elin694/BLDC-Motor-Kraken-x694/breadboard schematics/prototype-bldc-6-step-commutation_normalHighSide.txt

$ 1 0.00009999999999999999 0.6798259793203881 43 9 43 5e-11
w 448 368 448 416 0
w 32 320 32 352 0
w -16 352 -16 432 0
r -16 432 -16 496 0 1000
w 32 384 32 432 0
r 32 432 32 496 0 1000
w 80 416 80 432 0
r 80 432 80 496 0 1000
w -16 496 32 496 0
w 32 496 80 496 0
v -160 352 -16 352 4 5 100 5 0 2.0943951023931953 0.33
v -128 384 32 384 4 5 100 5 0 4.1887902047863905 0.33
v -160 416 -32 416 4 5 100 5 0 0 0.33
w -32 416 80 416 0
w -160 352 -160 384 0
w -160 384 -160 416 0
w -160 384 -128 384 0
w 448 448 464 448 0
d 464 448 464 416 2 default
w -160 416 -160 496 0
w -160 496 -16 496 0
s 112 192 112 128 0 0 false
s 32 144 32 64 0 0 false
s 192 320 192 288 0 0 false
s 112 320 112 288 0 0 false
s 32 320 32 288 0 0 false
v 1072 0 944 0 0 0 40 5 0 0 0.5
w 880 272 944 272 0
w 880 304 944 304 0
w 944 240 880 240 0
207 880 496 912 496 5 Power\sCap3
207 704 496 736 496 5 Power\sCap2
207 640 128 688 96 5 Power\sCap2
207 816 128 864 96 5 Power\sCap3
207 528 496 560 496 5 Power\sCap1
207 800 -32 720 0 5 Power_Gnd
207 -160 496 -96 464 5 Power_Gnd
w 448 368 464 368 0
w 464 416 496 416 0
207 624 480 624 544 5 Power_Gnd
w 112 320 112 384 0
w 464 448 496 448 0
w 192 320 192 416 0
w 640 448 672 448 0
w 640 416 672 416 0
w 624 368 640 368 0
d 640 448 640 416 2 default
w 624 448 640 448 0
w 624 368 624 416 0
w 800 368 800 416 0
w 800 448 816 448 0
d 816 448 816 416 2 default
w 800 368 816 368 0
w 816 448 864 448 0
w 448 448 448 480 0
w 624 448 624 480 0
w 800 480 800 448 0
w 464 128 496 128 0
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
o 70 1 0 x283016 5 0.1 4 2 1 10 0 70 3 0.2 0
o 217 1 0 x283016 5 0.1 5 2 1 10 0 217 3 0.2 0
38 12 F1 3 9 100 -1 F_CLow
38 11 F1 3 9 100 -1 f_BLow
38 10 F1 3 9 100 -1 F_ALow
38 206 F1 3 9 100 -1 f_Chigh
38 207 F1 3 9 100 -1 f_Bhigh
38 208 F1 3 9 100 -1 f_AHigh
