elin694/BLDC-Motor-Kraken-x694/code/x694_BlockComm/x694_blockComm_SinglePhaseTest/src/globals.h

#pragma once

// #define led_14 GPIO_NUM_14
#define GLOBALS_H
#define phaseAHighPort 33
#define phaseALowPort 14
#define phaseBHighPort 17
#define phaseBLowPort 16
#define phaseCHighPort 26
#define phaseCLowPort 32
#define pot 35 // or 35
// #define adcChannel 34
#define adcChannel ADC_CHANNEL_7 // diagonal pairing with physical placement

#define inlineShuntC 36 //Vp 
#define inlineShuntA 39 //Vn
