elin694/BLDC-Motor-Kraken-x694/code/x694_foc_arduinoFramework/src/parkClarkTestCases.h

#define CP_TEST_CASES
 float phaseA_test = 2; //phase A current
 float phaseB_test = 2; //Phase C Current
 float phaseC_test = -phaseA_test-phaseB_test; //Phase C Current
 float as5600input_test = 0; // 

 //input calcualted google sheets angle here
