elin694/BLDC-Motor-Kraken-x694/(commit log)

2025-10-18 shifted shunt resistor inwards and removed useless gpio4. made new version of the smae circuit in falstad2 with subcircuits
2025-10-20 made sub circuits + changed to decided values + having issues w/ inductor current only reaching 200mA
2025-10-21 added zener diodes and 555 timer to model
2025-10-22 adding 2uF and 60Ω Resistors dropped supply voltage to 10V, need to recalculate impedances
2025-11-09 edited Beta value and vth for all mosfets by using Falstad's calculator. Icnreased Pull down Resistor voltage from 10k to 100k
2025-11-10 Added acknowledgements.Updated Boost Converter subcircuit to v7. Changed r1 from 2k to 5.5k, r2 from 5.76k to 9k, and added a parallel resistor for 42.2% duty cycle and 9.174kHz pwm signal from 555 t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
2025-11-23 bread board version plan
2025-11-23 added schematic for breadboard proottyping. Will use rc snubbers, remove buck boost converter and differential operators, set maximum voltage to 5V. Still need to boot strap high side diodes. Will ru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
2025-11-23 converted all components in proototype to be suitable ffor 5V and Arduino
2025-11-26 finalized prototype schematic
2025-11-28 edited to reflect value sof real resistors used in prootytpe
2025-11-28 added the following files from PLATFORMIO: - DacTest - using esp32 DAC to generate a pseudo sine wave, and amplified it with a BJT common emitter amplifier to test and measure the inductance in wires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
2025-11-30 added subcircuit representing motor phases into pwmCycle(2N2222A dry run/3 phase commutation test). Updated prototype-bldc because we need a 1uF capcitor for the bootstraps, whichwe found after testi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
2025-12-07 reached 750rpm with 6 step commutation. Fixed commutation cycling in the 6 step comm code
    [bldcFocCrackInx694.ino, globals.h, initialize.cpp, intialize.cpp, main.cpp, portAssignments.h]
2025-12-07 edited protoype schematics to reflect and decide order of PWM for Gate switching
2025-12-14 Created minimal feedback loop with input range of 7.1 plus or minus 2.25V and outputs a range of 7.66 to 9.66 for the 555 timer's V_ctrl
2025-12-15 removed antiparallel normal diodes from main schemetic becuase there are TVS diodes already
2025-12-18 switching to RCD snubbers to minize power wasted on snubber resistors
2026-04-17 transferred main code to use espidf framework
2026-04-21 watchdog tiemr keeps resetting
    [Crackin694_Arduino_Oscilloscope.ino, globals.h, initialize.cpp, intialize.cpp, main.cpp, portAssignments.h]
2026-04-26 got a workign bldc running at 12.22222rps
    ''
    '
    cd code
    asds
    a
2026-05-10 Successfully ran MCPWM Test Code on one of the Motor phases
2026-05-10 6step: added as5600 offset, achieved 16 RPM with supposedly 12.4V battery
2026-05-16 6stepMCPWM:added preload and execute gate fucntions, cleaned up code. Still need to hook up timer phase sync to the timers
2026-05-22 6stepMCPWM: rameking code to use all 6 timers
2026-05-26 6stepMCPWM: first draft done over a 3 day break, currently debugging ISR issue
    [GateControl.h, Globals.h, Initialize.cpp, Initialize.h, gateControl.cpp, main.cpp]
2026-05-26 6stepMCPWM: plugged into esp32, and ran through errors with ESP_ERROR_CHECK and ESP_LOGW. Seems to work fine; will ned to plug into pcb to test
    [GateControl.h, Globals.h, Initialize.cpp, gateControl.cpp, main.cpp]
2026-05-30 6stepMcpwm didn't work with esp_intr_alloc()- esp_Pwm0_intr_source and esp_Pwm1_intr_source not
    [GateControl.h, Globals.h, Initialize.cpp, Initialize.h, gateControl.cpp, main.cpp]
2026-06-07 Fixed counter to actually count isr. Fxied LowGateLevelCycle to ensure all values evaluated to a float. grouped setters into setCountValueAndPeriod
    [GateControl.h, Globals.h, Initialize.cpp, gateControl.cpp, kill_frozen_monitor.py, main.cpp]
2026-06-08 -coutners all incrememnt to ensure correct operator id -lowgatelevelCycle multiplied by 3 since we want it to be based of of LowTiemr, not Btimer. - also converted from float to int since freeRtos de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
    -remember to revert activePwmPeriod
    - figured that isrs were looking for some wrong interrupt pins
    [GateControl.h, Globals.h, Initialize.cpp, gateControl.cpp, main.cpp]
2026-06-08 -deleted superOld version of execute gates (that used steps[-1,0,1] _ currently figuring out why execute gates can't take both soft syncs at once todo- connect high gate cmr to pot 2
2026-06-09 Overall- low timer seems to be performing properlyh when the motor is not stalling. ----I think that syncing to an intr = value can cause trigger isr -cam't run readpot - disabling it seems to fix BT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
    tips:
    - software activate syhnc seems to happen on peripheral and not cpu
    Issues resolved:
    - seems like Ltimer activate before Btimer at startup because printing has caused one time to get ahead of another
    [Globals.h, Initialize.cpp, gateControl.cpp, main.cpp]
2026-06-10 - phase AH on while phase CH blinking resolved: low timer needed a direction set from the beginning with the proper sync direction. The startingTargetSector parameter passed in was not consistent wit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
    I think motor stalling is fine, we jsut need to ensure that the Low gates are forced down?
    reminder to undo commenting out gen force set level
    [GateControl.h, Globals.h, Initialize.cpp, Initialize.h, gateControl.cpp, main.cpp]
2026-06-10 -increased Btimer and Ltimer priority Thoguhts: - pinSetup might be hindering performance because of pullups and pulldowns - turned off pulldown and dt
    Current Problems-
    - Red led is supposed to be on, but seems like something is suppressing it
    - Yellow led should be off, but it is belinking- overshoot
    [GateControl.h, Globals.h, Initialize.cpp, gateControl.cpp, main.cpp]
2026-06-12 Generator_action toggle on comparator event solved flickering. - printf debug to tell what block it is, and adjust high level
    - resolved issue with blinking phase 1 at sector 0 using gen_set_force_lvl
    - modified debug log to now alternate between motorStalls and motorSpinning
    [Globals.h, Initialize.cpp, gateControl.cpp, main.cpp]
2026-06-12 fixed blinking and have 2 low gates on at stall (now only 1.25 of them are on)! - starting to reintroduce highGate code
    [Globals.h, Initialize.cpp, gateControl.cpp]
2026-06-12 Changes: - deleting apple code in firstpreload+ preloadGates Function that used v1 highgate Control Method (cahanging timer periods) -reenable deadtime - tested High phase fucntions, but led is not b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
2026-06-13 - task ReadPot bugging out due to taskEnterCritical - used takeENTER_CRITICAL_ISR in isr -removed set Phase on sync for btimer in preloadGates
    [Globals.h, Initialize.cpp, gateControl.cpp, main.cpp]
2026-06-14 Problem- after attempting to enabled the TaskCritical section, the motor would stop stalling, even when it should be in a stalled state. Turns out, only block Period was pushed (synced), and LTIMER d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
    Normal testing 6 bloc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
    [Globals.h, Initialize.cpp, gateControl.cpp, main.cpp]
2026-06-14 finished! Attached 6 leds and ran code. The gate gpios were reassigned. Code works fine on motor stall and the first new period update.
    [Globals.h, Initialize.cpp, gateControl.cpp]
2026-06-14 edits with generator_set_force_level(gen, -1,true) to keep the gates low (and prevent shorting gates on same phase) during initialization of MCPWM (and creating new mcpwm objects/ modules)
    [Globals.h, Initialize.cpp, gateControl.cpp, main.cpp]
2026-06-14 finished preprocessor directives to switch between testmode and real controller mode
2026-06-15 Starting over again on minie breadboard- at startup all 3 HighGates are high - creating a task so we can read As5600 outside of isr1 because I2C transmit and Read can't be done in isr. - i2c write + 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
    - i2c transmit recieve icnrements index automattically to shuffle to next byte, even when writing 2 bytes
2026-06-16 NEW CHANGE- get sector number and both isrs wil only consider the new gate. All low gate events are terminated- trust in the dead time (absolute, not relative)
    More preprocessor directives used to toggle debug settings
    LED Test mode works
2026-06-16 i2c notr working (I2C software timeout)
2026-06-16 still debugging why i2c no work
2026-06-16 logging in terminal for i2c in 6block not roque control
2026-06-17 the i2c is not cooked, but the wire conenctors are. i think the coed should be working fine here
2026-06-18 I2c error was due to not connecting dir pin; issue fixed, as5600 is able to read in consistent time now. Now re-zeroing the as56000
    [Globals.h, main.cpp]
2026-06-19 found minimum timer resolution of 2432hz and period of 65535 ticks, which leads to a maximum period time of 26.9469 Seconds. Also rewrote the x694_espidf_MCPWM to be suitabel for phase test
2026-06-19 replaced funciton for gettin global.rotorVal with preprocessor directives to reduce #lines
    [Globals.h, Initialize.cpp]
2026-06-20 removed debug prints, and shifted phases in as5600 calibration code
2026-06-21 fixed as5600 calibration and secttarget values; isolated case when as5600 direction pin is high when calibrating vs when it is high while motor is polling. works
    [Globals.h, Initialize.cpp, main.cpp]
2026-06-23 Increased i2c clock to 900kHz (safe) - 90% duty at 1kHz is ok; the phase simple can't be left floating working
2026-06-23 correcting mcpwm calibration duty cycle so it isn't 1 less than what its supposed to be
    [main.cpp]
2026-06-23 New as5600 calibrated value (dir pin low). working.
2026-06-23 saved new calibrated values to 6 block(no torque), and print controls. - draws 90mA with 14V bbc. it is not as good as before
2026-06-23 WORKING! REPLACE GEN FORCE LEVEL FOR HIGH GATES TO -!!
    [Globals.h, Initialize.cpp, gateControl.cpp]
2026-06-23 simplifying ltimer so Btimer period can range over more values. Surgery successful, rotation is fine. RPM is 1670. 14.4 smth V. prints S when stalled.
    [Globals.h, Initialize.cpp, gateControl.cpp, main.cpp]
2026-06-23 reorganized control panel, figuring out how to make last timer for Velocity control:
    400000/(18*200) =111.11 RPS
    BPR = blockProgressionRate timer
    (BPR.resolution_hz)/(<rotation--> block conversion>*minimum BPR.period_ticks)
    = with a BPR.resolution_hz, we can get a maximum rps of 111.11 at our minum BPR.period_ticks
2026-06-23 starting to implement velocityTrackerTimer. search for ^& for where we last left off. Working
2026-06-24 VTimer priority issue resolved; all timers in the same group share the same intr LVL. Issue resolved. Maximum and mimum RPS now determined by VtimerResolution.
    RPS and Block Period calculations from readingPot are verified to be working. Everything else isn't.
    - problem resolved-Vtimer count seemed to be Drifting. Used sync on every phaseSwitch flag in execute gates.
    - Modified first preload so it doesn't force gate level of a highside mosfet to high.
    - editing precale by writing to register directly. Seems to be fine with 4MHz tiemr resolution and 400khz VTimer resolutions
    [GateControl.h, Globals.h, Initialize.cpp, Initialize.h, gateControl.cpp, main.cpp]
2026-06-25 Code cleanup. added flag so isr1 so isr2 can't execute befoere isr 1. Motor is working, but oscillates due to moemntum at 1rpm or less
    [Globals.h, Initialize.cpp, Initialize.h, gateControl.cpp, main.cpp]
2026-06-26 i2c nack timeouts due to EMI. Added Error handling (motor stalls) when a case occurs. Tested and blew up Low Side TVS2200DRVR. Its the third time this happened, and it always happens on low side mosf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
    [Globals.h, Initialize.cpp, gateControl.cpp, main.cpp]
2026-06-26 increased i2c clock frequency back to 800khz
2026-07-01 - remvoed RPS and reanmed target velocity. - added enums for 3 control types, that affects readpotonce - velocity control should still work - added basic pid, math should be right
2026-07-02 167-8 when meauring t1 from isr2 start to very end of preload gates, 157-8 otherwise -taskResume in isr1 replaced with vTaskNotifyGiveIndexedFromISR, and ulTaskNotifyTakeIndexed replaces vTaskSuspend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
    "Working"- i2c software error occurs frequently when running, but when only esp32 is pwoered, it happens, jsut less frequently.
    to do:
    - transmit at the end of getSector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
    [Globals.h, Initialize.cpp, gateControl.cpp, main.cpp]
2026-07-03 In this commit: - keeps giving i2c software timeout when idle - also gives i2c hardware nack (and timeout) when running -resolved case when global.newPhaseSwitchFlag does get removed if dir=0
    effective changes in 6e17dddd69115da28a06a2a0e9e4aa475f918bf0 (a working commit):
    - debug log stack from 10k to 5k
    - mathitout has 0 delay
    - swapped rps with global.targetVel.
    effective changes in 2136c9841ba4da14542a73aa47e9110d950355c7(not working):
    - sdk config stuff
    - clock from 800khz to 900kHz
    -remove dram t1
    -i2c timeout from1 5ms to 1ms, read time +1
    -- // esp_rom_delay_us(ticksToµs+1);
    [Globals.h, Initialize.cpp, gateControl.cpp]
2026-07-03 remove debug i2c from menuconfig
2026-07-04 Begining to simplify i2c disconnect problem -setting pot read value constant dir =0 when gsn i2c read fails, bP set out of boudn in read Pot repeat, or in preloadGates - replaced - dir=0 with a freeS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
    [Globals.h, Initialize.cpp, gateControl.cpp, main.cpp]
2026-07-04 renamed newest sdk to sdkconfig.esp32doit-devkit-v1og. New code seems to have 5 issues in 5 mutes or run time (emulated pot-reading). Battery at 12.2V and bbc @ 17.3V. Working, although Iw a able to 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
    [Globals.h]
2026-07-04 - motor speed is around 3x faster when target, that should be solved via pid - motor direction reverses if enough reverse torque is applied. - somehow initialized and declared dir value affects spin 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
    [Globals.h, Initialize.cpp, gateControl.cpp, headers.h, main.cpp]
2026-07-04 no idea why, but i2c erros occur much less often with (debug_dontReadVelocityPot) toggled on than off.
    Working
2026-07-05 critical section is causing i2c read problems, finding which line it is - confirmed by running actual code (not emulated) without critical section - problem is repeatable -newVelPotValue is a part (m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
    [Globals.h, Initialize.cpp, Initialize.h, gateControl.cpp, main.cpp]
2026-07-05 shifted the soft-sync from execute gates to preload made all flags use atomic operations in isr1 and isr2 working but still ahs i2c problems
    [Globals.h, gateControl.cpp, main.cpp]
2026-07-05 more replacing flags with atomic operation. Working (still has minor i2c timeouts)
2026-07-05 reaplced update period on sync with update period on empty on Vtimer working- i2c error legit erased
    [gateControl.cpp]
2026-07-05 increased clock speed to 1MHz - as5600 still works fine, and i2c wires are not hypersensitive to tocuh Working!
2026-07-05 reduce setup task stack size - included ansi esc sequences -working!
2026-07-05 - halfed max target speed back to 20RPS - split freespin into 2 states so a motor can temporarily freespin without losing the knowledge of it current state - solved motor not stopping issue- turn the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
    WORKING!
    [Globals.h, Initialize.cpp, gateControl.cpp, main.cpp]
2026-07-06 attemtped to add freespin when i2c unread functionality, but its nto working. Working!
2026-07-06 ok final code celanup before adding pid stuff
2026-07-06 globals.h safe, working! (although ISR1 seems to repeat itself, which suggests its taking>500us to do i2c read)
2026-07-06 Working! - toggleable ebtween vtask delay for loop and using esptimer for gsn loop! -achieving 200us loop on i2c read (5KHz)
2026-07-06 -made edits to ansi code -need to implement current rampup?
2026-07-06 printing, working
2026-07-07 -not working, i2c errors oof -remove volatile from global? - move all variabels to start of mathiout
    [Globals.h, gateControl.cpp, main.cpp]
2026-07-08 platformio,ini and sdk remade in 6b_mcpwm, tested 1Mhz i2c speed triggered by esp_callback task on that file as well, reached 6250Hz poll rate.
    - made tag, and tag flag to clean up code
    -shift init intr enable fucntionf rom GCC to init.cpp
    - true skip unhandle events in esptimer to show in esp_timer_dump
    -massive init.cpp changes
    [Globals.h, Initialize.cpp, Initialize.h, gateControl.cpp, headers.h, kill_frozen_monitor.py, main.cpp]
2026-07-08 - fixed modulo error for isr2currentCoutner -esp_transmit recieve nowchecks for esp-ok directly -the above was found with copying the style to 6B mcpwm - added intr dump removed use of toggle ebtween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
    WOrks after some time
    -make isr for i2c happen in core 1?
    [ANSI.h, Initialize.cpp, headers.h, main.cpp]
2026-07-10 rewriteing without initializers - only high side is cut off when motor freespins -gcc code cleanup - shifted vTimer start fucntion to interrupt enable 2 -tht timers period is initialized in the phase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
2026-07-10 midway adding pid loops
2026-07-10 operator udpate action on tez for high gates - started working on velocity and position control pid but currently isn't running - motor spins but still heavy i2c error - seems liek i2c interrrupt is 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
    [Initialize.cpp, gateControl.cpp, main.cpp]
2026-07-11 made i2c interrrupt run on core 1 by pinning as5600 initialization task to core 1
2026-07-11 i2c error appear more frequently when i double poll rate to 200. WOrking!
    [Globals.h, Initialize.cpp]
2026-07-11 -added portYield to isr from isr3 - remove comments -removed mod 6 -grouped some predefs -added isrPeriorities levels in globals.h modified isr config for ideal intr_priority in config settings, but 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
    [GateControl.h, Globals.h, Initialize.cpp, Initialize.h, gateControl.cpp]
2026-07-11 monitorng tag flag - if global.readAS5600 is ever on before i2c_transmit, its dead after (isr2 happen in middle of i2c transmit) - should not be on consiering ltimer is running 8x faster than gsn. hy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
    combinations to try
    - motor on vs off
    - 111, ,11,21,
    -with and without major mutexes
2026-07-12 - ran task highWaterMark and reduced task stack size of setup and readPOtvalue - spamming std::memory_order::relaxed on all atomic operations close to or after gsn to reduce i2c errors. (error caus e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
    -commenting out mcpwm_timer_set_period removes all i2c errors (x nope), will push this to a lower priority task
    [Globals.h, Initialize.cpp, gateControl.cpp, headers.h, main.cpp]
2026-07-14 only aded 6b mcpwm and calibration folders into this wkspace
2026-07-14 Updating espidf to v6.0.1. Both calibrator and code compiles error free. added remove initalizer need to be explicitly set flag to platform.ini
    -deleted .pio folders and regenerated sdkconfigs
    Chnages:
    Bootloader config- set flash log to warning level, format with color, + timestamp
    serial flasher config- detect flash size when flashing bootloader. enable Qio (instead of DIO) and 80Mhz clock flashing
    Component config==========
    - i2c iram safe +enable i2c log
    - mcpwm isr can execute with disabled cache + mcpwm contorl functions in iram + force enable debug log
    -uart isr function placed into iram
    esp_stdio- custom usrt0 at 921600 baud
    system settings- 240MHz cpu , invoke panic handler on task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
    [GateControl.h, Initialize.h, gateControl.cpp, headers.h, main.cpp]
2026-07-15 intr priority of operator can't be ocnflicting, removed allow timer pd on all. working mcpwm_calib w/ no i2c erros
2026-07-15 its ok to change i2c intr. priority, but transfer depth queue must be 0- otherwise you get follwoing error:
    E (10237) task_wdt: Task watchdog got triggered. The following tasks/users did not reset the watchdog in time:
    E (10237) task_wdt: - IDLE1 (CPU 1)
    E (10237) task_wdt: Tasks currently running:
    E (10237) task_wdt: CPU 0: IDLE0
    E (10237) task_wdt: CPU 1: i2c reader
    E (10237) task_wdt: Aborting.
    E (10237) task_wdt: Print CPU 1 backtrace
    [headers.h, main.cpp]
2026-07-15 velSetPeriod ticks is off, and i2c transmit always reports that its fine
    had issue where i2c wouldn't read (value stayed the same) but adc was, and motro was on freespinning/stalling (stuck in a state)
    - commented out allow pd and uxGetTaskPriority
    -killed rindex and rA[10000]
    -remvoed gen set low when tez and modified gen action
    [Globals.h, Initialize.cpp, Initialize.h, gateControl.cpp, headers.h, main.cpp]
2026-07-15 taking 23 us to finsih i2c transmit
2026-07-15 removed casting in gsn i2c trnasmit
2026-07-16 -trans_queue depth enables i2c async -i2c transmit time raaised up to 210us- seems to be a config issue
    -setttings modified within v5.3.2 sdkconfig caused the i2c large delay- tested with 4 sdkconfigs
    [Globals.h, Initialize.cpp, Initialize.h, main.cpp]
2026-07-16 -added i2c iram safe to v6 og sdk
2026-07-16 changed uart in ram, cpu freq to 160
2026-07-16 currently at 210us a read, changed cpu freq back to 240
2026-07-16 calib has same sdkcondig as main - i2c errors don't happen in calibration code with same clk frequency (1MHz) and high. Duty at esp_timer period of 200us
    [Globals.h, Initialize.cpp, gateControl.cpp, headers.h, main.cpp]
2026-07-16 -implemented better filter -tag flag mod Working without preload gates
    -test mcpwm tiemr instead of that other timer
    - cleanup btimer and ltimer
    - set PM to 00 (nom) in as5600
2026-07-16 moved pid loop controller code to its on cpp file -1s panic reboot delay. removed old sdkconfigs
    [Controller.cpp, GateControl.h, Globals.h, Initialize.cpp, gateControl.cpp, main.cpp]
2026-07-16 fixed minor error -added lastResort toggle
    [Globals.h, Initialize.cpp]
2026-07-17 renamed to 6B_MCPWM to calibration
2026-07-17 -2c read don't work well with hgih duty readTime < 170us!
    -shift isr counter variables form globals.h to gsn task
    - remamed couting and tiemr variables
    - made a universal isr function
    -cmmneted out gsn's data processing
    - shifted more things to controller cpp/.h
    - turned gllobal.readAS5600 to a uint32_t
    -code cleanup
    -MAXIMUM sensitivity brownout detection (2.8 or less
    - enabled gdb stub
    [Constants.h, Controller.cpp, Controller.h, GateControl.h, Globals.h, Initialize.cpp, Initialize.h, gateControl.cpp]
2026-07-17 mirrored 6b code to calibration code
2026-07-17 reanemd variable/fucntions and used preprocessor definitions to shrothand time fucntions
    after 16s
    - gsn has 62% run timer on core 1
    - idle0 has 99% runtiem on core 2
    - xPortGetRunTimeCounterValue uses sae timer as esp_timer
2026-07-17 made execute gates into a task that executes only onec, but i2c still gives errors I also tried with it executed once before any other task was created, but i still get errors
    Will attempt starting from calibration code
    [Constants.h, GateControl.h, Globals.h, Initialize.cpp, gateControl.cpp]
2026-07-17 revert init.cpp if need be - merged calib code to there
    [Initialize.cpp, headers.h, main.cpp]
2026-07-17 glitch-ignore coutn added back to main again
    [Initialize.h]
2026-07-18 - reverted to og pinsetup -stgcmp
    [main.cpp]
2026-07-18 Working! Only prints i2c error at start.
    Causes of I2c errors
    - gatecmp val
    - vtaskdelay at startup
    [Globals.h, Initialize.cpp, gateControl.cpp, main.cpp]
2026-07-18 Working! (not pot read yet) -800ms i2c error at start-
    1. print rps -- doesn't cause issues by itself.
    2. Timer/task Dump (causes .9-->26.5 = 25.6s of i2c error = 32 loops)
    [Globals.h, Initialize.cpp, gateControl.cpp, main.cpp]
2026-07-18 working with pot read! Esptimer intr priority set 2 -sdk config- with -02 optimaization and espTimer intr priority 2 --> 197/197 <150us -1.3MHz+ clock -->i2c error (pro need stronger pullups)
    -1.4MHz clock --> 20% goes over 150us
    taps out at 1.42Mhz --> 145 error rate
    [Controller.h, Globals.h, Initialize.cpp, main.cpp]
2026-07-18 **CHECKPOINT 1: - add spinlocks after pid done - MCPWM_LowsideIntrPriority 1 to 2 -fixed issue where it could only spin in 1 direction
    code cleanup
    - del getTimerCountNow
    - made preproc-dir CLEAR_ALL_NOTIFS();
    [Constants.h, Controller.cpp, Globals.h, Initialize.cpp, Initialize.h, gateControl.cpp, main.cpp]
2026-07-18 getting a lot of i2c errrors
    made pid structs in controller.h
2026-07-18 Working! -Errors likely coincide with esp_timer_dump_cycles - more header reorganization and code cleanup
    [Constants.h, Controller.cpp, Globals.h, gateControl.cpp, main.cpp]
2026-07-19 i2c errors Swapping esp_timer for GPT_timer.
    [Constants.h, Controller.cpp, Globals.h, Initialize.cpp, Initialize.h, gateControl.cpp, main.cpp]
2026-07-19 line of code that was causing i2c software timeouts // float localTargetVelocity = (fMin+(fMax-fMin)*processedData/4096.0f); /*OLD*/ // vbPeriod_temp= (uint32_t)(VTimerResolution/fabsf(localTargetVel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
    // float localTargetVelocity = (fMin + (((fMax - fMin)/4096.0f) * processedData)); /*NEW*/
    // vbPeriod_temp= (uint32_t)((VTimerResolution / electricalCycles) / fabsf(localTargetVelocity)); /*NEW*/
2026-07-19 Applied changes below to before ckpt1:
    -replaced software limit to target_min/max for torque and position in potread
    -changed reported min max rps values to target_velocity_Ub/LB -----------
    -removed static assert from app_main ---------
    - gsn: reading variable changed back to uint32_t from int
    - did not change target pos/accel for other control methods --------
    - 2x probe time (2us waitout)---
    - rmv timer dump from debugMonitor and from startup ----------
    - replaced the 2line block code from main cpp to the version before CKpt1
    [Constants.h, Initialize.cpp, main.cpp]
2026-07-19 **Checkpoint2 Working without i2c errors switching to gptimer next
    [Globals.h]
2026-07-19 Gptimer not working :( added GPTIMER and tagged it with iram_ATTR. Enabled all associated functions in menuconfig - added gsntask and egTask and as5600handles to dram
    [Constants.h, Globals.h, Initialize.cpp, Initialize.h, main.cpp]
2026-07-19 Made option to automatically reroll deck for a working i2c. Working - Disabled GDB stub so we can use an awesome tree when i2c sucks (3.5sec) -toggeable dumping - set as5600 PM bits to 00 to prevent 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
    [Globals.h, Initialize.cpp, Initialize.h]
2026-07-19 Working! Rearranged code order within same filess. Reordered control_type related variables. Created torque control Loop function + isr.
2026-07-21 added torque control loop to init.cpp. made as5600 a array
    - changed Htimer rez from 4Mhz to 80Mhz
    -target positions as an integer
    - edited control loops and reorganzied controller.cpp.
    -Should double check startup cases lol
    - consider making it so that all control loops now only read from the _kpid except for the current loop, structs so integration has a higher resolution; however, pid must be calculated at that frequency for each controlLoop
2026-08-21 To test: -exe gates remove condition to relase latch on high gates- using multiplication instead - made toggleable pre processor directive to enabe PID controls one at a time or to use feedforward -r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
    [Constants.h, Controller.cpp, Globals.h, Initialize.cpp, Initialize.h, gateControl.cpp, main.cpp]
2026-08-22 Not Tested. -ctrll loop: using task notif to check if rotor value is recent. - when ctrl loop pid is active, block period runs close to As5600 update limit
    reminders:
    -posiion bounrds
    -dt_s for each loop can be constant (using clck frequency) or realistic (measuring time diff like in tqloop)
    -encoder unit is in bits not angle
2026-08-22 Not tested: - htimer rez maximized to 160Mhz and fixed deadtime - filter on other Loops to be implemented later
    [Constants.h, GateControl.h, main.cpp]
2026-08-24 Not tested- - adjusted encoder calibration so i can toggle based on commutation type - Made direction a preprocessor directive - made deadtime > 50ns Depending on Htimer resolution - added toggle bet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
2026-08-24 not tested, modified calibration
2026-08-24 added esp32-s3 FOC folder
